AstroPlant/astroplant-hardware/Electronics/README.md

# AstroPlant Electronic

At this time there is 3 main PCB in the project:

* Extension board
* LEDs panel
* EC-pH board

The *Extension board* and the *LEDs panel* are made internaly by the AstroPlant team using kicad 5
The libraries can be found here : https://framagit.org/VincentFrangi/KiCad_AstroPlant_Lib.git

The *EC-ph board* is made by [Sparky's Widgets](https://www.sparkyswidgets.com/)

## Documentation
