AstroPlant/astroplant-hardware/Electronics/PCB/AstroPlant_ExtensionBoard/astroplant-extension-board-mk0-7/Outputs/GERBER v07/Readme.txt

To have a gerber working on eurocircuit you need zip it with the drill files
