AstroPlant/astroplant-hardware/Electronics/PCB/AstroPlant_ExtensionBoard/astroplant-extension-board-mk0-6-1/3D_model/ExtensionBoardMk06.stl

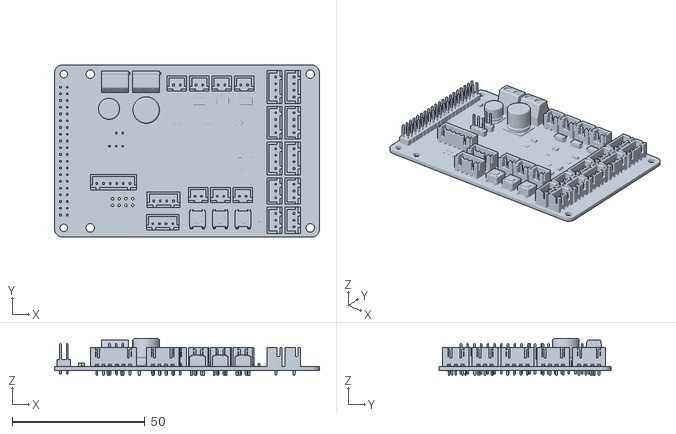
[picture p1: CAD file, 2023-10-30]
Electronics/PCB/AstroPlant_ExtensionBoard/astroplant-extension-board-mk0-6-1/3D_model/ExtensionBoardMk06.stl
100.0 x 65.0 x 14.0
