AstroPlant/astroplant-hardware/Electronics/PCB/AstroPlant_ExtensionBoard/astroplant-extension-board-mk0-7/Astroplant_AL.kicad_pcb

## KiCad design Electronics/PCB/AstroPlant_ExtensionBoard/astroplant-extension-board-mk0-7/Astroplant_AL.kicad_pcb (2023-11-22)

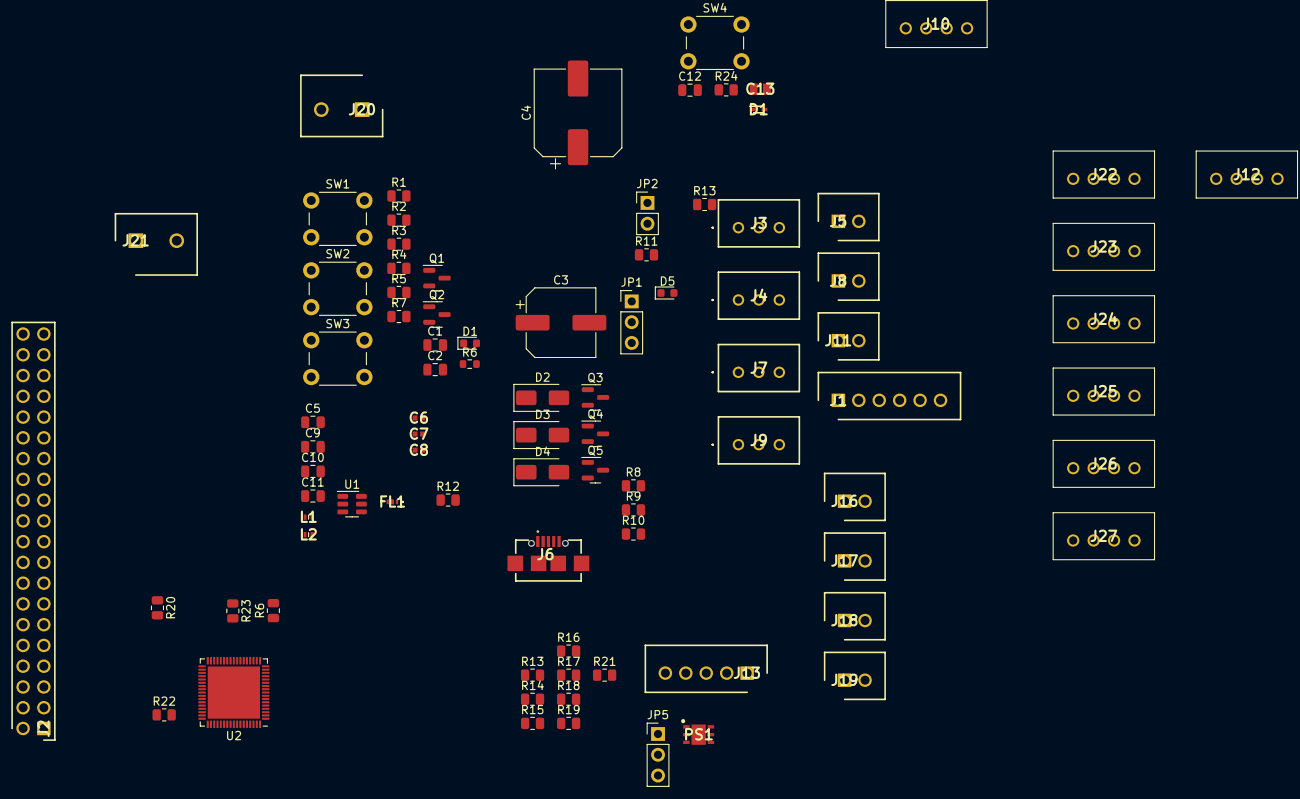
[picture p2: board Astroplant_AL.kicad_pcb from above]

Board: 2 copper layers, 88 parts (0 on the bottom side), 61 nets, no tracks yet.

Parts:
C1, C2, C5, C9, C10, C11, C12: 0.1uF; C_0805_2012Metric
C3: 470uF; CP_Elec_8x6.9
C4: 470uF; CP_Elec_10x10.5
C6: GRM1555C1H1R2WA01D; CAPC1005X55N
C7: GRM1555C1HR30WA01D; CAPC1005X55N
C8: GRM1555C1HR80BA01D; CAPC1005X55N
C13: 885012207027; CAPC2012X90N
D1: LED_Blue; LED_0603_1608Metric
D1#2: BAT54KFILM; SODFL1608X70N
D2, D3, D4: S1A; D_SMA
D5: LED_Amber; LED_0603_1608Metric
FL1: LFB182G45CGFD436
J1: JST_XH_Relays; SHDR6W64P0X250_1X6_1740X575X700P
J2: 2x40 2.5mm Header; HDRV40W64P254X254_2X20_5080X508X869P
J3, J4, J7, J9: JST-XH_3; B3BXHALFSN
J5, J8, J11, J16, J17, J18, J19: JST_HX_2; SHDR2W64P0X250_1X2_740X575X700P
J6: 629105136821; MICRO-USB_2.0-SMT-TYPE-B_
J10: JST_XH_UART; B4BXHALFSN
J12: JST-XH_LED_GND; B4BXHALFSN
J13: B5B-XH-A_LF__SN_; SHDR5W64P0X250_1X5_1490X575X700P
J20, J21: Conn_01x02; SHDR2W100P0X500_1X2_1000X750X990P
J22, J23, J24, J25, J26, J27: JST_XH_I2C; B4BXHALFSN
JP1, JP5: Jumper_3_Bridged12; PinHeader_1x03_P2.54mm_Vertical
JP2: Jumper_2_Bridged; PinHeader_1x02_P2.54mm_Vertical
L1: LQG15HS3N6S02D; LQG15WH0N7B02D
L2: LQG15HS2N7S02J; LQG15WH0N7B02D
PS1: LD39050PU33R; SON95P300X300X100-7N-D
Q1, Q2, Q3, Q4, Q5: IRLML6344TRPBF; SOT-23
R1, R2, R3, R4, R5, R6, R7, R12, R13, R13#2, R14, R15, R16, R17, R18, R19, R20, R21, R22, R23, R24: 10K; R_0805_2012Metric
R6#2: 27; R_0603_1608Metric
R8, R9, R10: 100K; R_0805_2012Metric
R11: 180; R_0805_2012Metric
SW1, SW2, SW3, SW4: SW_Push; SW_PUSH_6mm
U1: USBLC6-2SC6; SOT-23-6
U2: STM32WB55RGVx; QFN-68-1EP_8x8mm_P0.4mm_EP6.4x6.4mm

Connections:
3.3V_Generated: JP5.1 (A), PS1.4 (VOUT)
3.3V_RPi: J2.1 (3V3), J2.17 (3V3), JP5.3 (B)
5V_IN: C3.1, J20.1, JP1.1 (A), JP2.1 (A)
5V_RPi: C1.2, J2.2 (5V), J2.4 (5V), JP1.3 (B), JP2.2 (B)
+3V3: C2.2, C5.2, C9.2, C10.2, C11.2, C13.1, J1.1 (DC+), J3.2 (PW), J4.2 (PW), J6.1, J7.2 (PW), J9.2 (PW), J22.3 (PW), J24.3 (PW), J25.3 (PW), J27.3 (PW), JP5.2 (C), Q1.1 (G), Q2.1 (G), R1.1, R3.1, R5.1, R7.1, U1.5 (VBUS), U2.1 (VBAT), U2.14 (VDDA), U2.30 (VDD), U2.33 (VDDRF), U2.45 (VDD), U2.55 (VDDUSB), U2.68 (VDD)
+5V: J10.3 (PW), J23.3 (PW), J26.3 (PW), JP1.2 (C), PS1.1 (EN), PS1.6 (VIN), R2.1, R4.1, R11.1
+24V: C4.1, D2.1 (K), D3.1 (K), D4.1 (K), J16.1 (A), J17.1 (A), J18.1 (A), J19.1 (A), J21.1
GND: C1.1, C2.1, C3.2, C4.2, C5.1, C6.2, C7.2, C8.2, C9.1, C10.1, C11.1, C12.1, C13.2, D1.1 (K), D5.1 (K), FL1.2 (GND), J1.2 (DC-), J2.6 (GND), J2.9 (GND), J2.14 (GND), J2.20 (GND), J2.25 (GND), J2.30 (GND), J2.34 (GND), J2.39 (GND), J3.3 (GND), J4.3 (GND), J5.2 (B), J6.5, J7.3 (GND), J8.2 (B), J9.3 (GND), J10.4 (GND), J11.2 (B), J12.4 (GND), J13.5, J20.2, J21.2, J22.4 (GND), J23.4 (GND), J24.4 (GND), J25.4 (GND), J26.4 (GND), J27.4 (GND), PS1.2 (GND), PS1.7 (PAD), Q3.2 (S), Q4.2 (S), Q5.2 (S), R8.2, R9.2, R10.2, R12.2, R24.1, SW1.2, SW2.2, SW3.2, SW4.1, U1.2 (GND), U2.32 (VSSRF), U2.42 (VSSSMPS), U2.69 (VSS)
GPIO4: J2.7 (GCLK0/GPIO4), J7.1 (DATA), J9.1 (DATA), R7.2, R23.1
GPIO5: J2.29 (GCLK1/GPIO5), J5.1 (A), SW1.1, U2.38 (PB0)
GPIO6: J2.31 (GCLK2/GPIO6), J8.1 (A), SW2.1, U2.39 (PB1)
GPIO7: J2.26 (~CE1/GPIO7), J11.1 (A), SW3.1, U2.27 (PB2)
GPIO12: J2.32 (PWM0/GPIO12), Q3.1 (G), R8.1, U2.6 (PB8)
GPIO13: J2.33 (PWM1/GPIO13), J13.1, R6#2.1, R13.2
GPIO16: J2.36 (GPIO16), Q5.1 (G), R10.1, U2.28 (PB10)
GPIO17: J2.11 (GPIO17), J3.1 (DATA), J4.1 (DATA), R5.2, R22.1
GPIO18: J2.12 (GPIO18/PWM0), J12.2 (FAR), J13.3, R6.2
GPIO19: J2.35 (GPIO19/MISO1), Q4.1 (G), R9.1, U2.23 (PA8)
GPIO20: J2.38 (GPIO20/MOSI1), J12.1 (RED), J13.2, R15.2
GPIO21: J2.40 (GPIO21/SCLK1), J12.3 (BLUE), J13.4, R14.2
GPIO22: J2.15 (GPIO22), R21.1
GPIO23: J2.16 (GPIO23), R20.1
GPIO24: J1.4 (CH2), J2.18 (GPIO24), R16.1
GPIO25: J1.5 (CH3), J2.22 (GPIO25), R17.1
GPIO26: J1.6 (CH4), J2.37 (GPIO26), R18.1
GPIO27: J1.3 (CH1), J2.13 (GPIO27), R19.1
unnamed: C6.1, L1.2
unnamed: D1.2 (A), R6#2.2
unnamed: D1#2.1, SW4.2
unnamed: D2.2 (A), J16.2 (B), Q3.3 (D)
unnamed: D3.2 (A), J17.2 (B), Q4.3 (D)
unnamed: D4.2 (A), J18.2 (B), J19.2 (B), Q5.3 (D)
unnamed: D5.2 (A), R11.2
unnamed: FL1.1 (IN), L1.1
unnamed: C7.1, FL1.3 (OUT), L2.2
unnamed: J6.2, U1.4 (I/O2)
unnamed: J6.3, U1.6 (I/O1)
unnamed: J6.4, R12.1
unnamed: C12.2, D1#2.2, U2.8 (NRST)
unnamed: R13.1, U2.15 (PA0)
unnamed: R14.1, U2.16 (PA1)
unnamed: R15.1, U2.17 (PA2)
unnamed: R6.1, U2.18 (PA3)
unnamed: U1.3 (I/O2), U2.52 (PA11)
unnamed: U1.1 (I/O1), U2.53 (PA12)
unnamed: R23.2, U2.26 (PC5)
unnamed: R22.2, U2.50 (PC6)
unnamed: R21.2, U2.58 (PC10)
unnamed: R20.2, U2.59 (PC11)
unnamed: R16.2, U2.60 (PC12)
unnamed: R17.2, U2.2 (PC13)
unnamed: R18.2, U2.3 (PC14)
unnamed: R19.2, U2.4 (PC15)
unnamed: R24.2, U2.5 (PH3)
unnamed: C8.1, L2.1, U2.31 (RF1)
RX: J2.10 (GPIO15/RXD), J10.2 (RX), U2.51 (PA10)
SCL: J2.5 (SCL/GPIO3), J22.2 (SCL), J24.2 (SCL), J25.2 (SCL), J27.2 (SCL), Q2.2 (S), R3.2, U2.65 (PB5)
SCL_5V: J23.2 (SCL), J26.2 (SCL), Q2.3 (D), R4.2
SDA: J2.3 (SDA/GPIO2), J22.1 (SDA), J24.1 (SDA), J25.1 (SDA), J27.1 (SDA), Q1.2 (S), R1.2, U2.66 (PB6)
SDA_5V: J23.1 (SDA), J26.1 (SDA), Q1.3 (D), R2.2
TX: J2.8 (GPIO14/TXD), J10.1 (TX), U2.24 (PA9)
