AstroPlant/astroplant-hardware/Electronics/PCB/AstroPlant_ExtensionBoard/astroplant-extension-board-mk0-6-1/Astroplant_VFR.kicad_pcb

## KiCad design Electronics/PCB/AstroPlant_ExtensionBoard/astroplant-extension-board-mk0-6-1/Astroplant_VFR.kicad_pcb (2023-10-30)

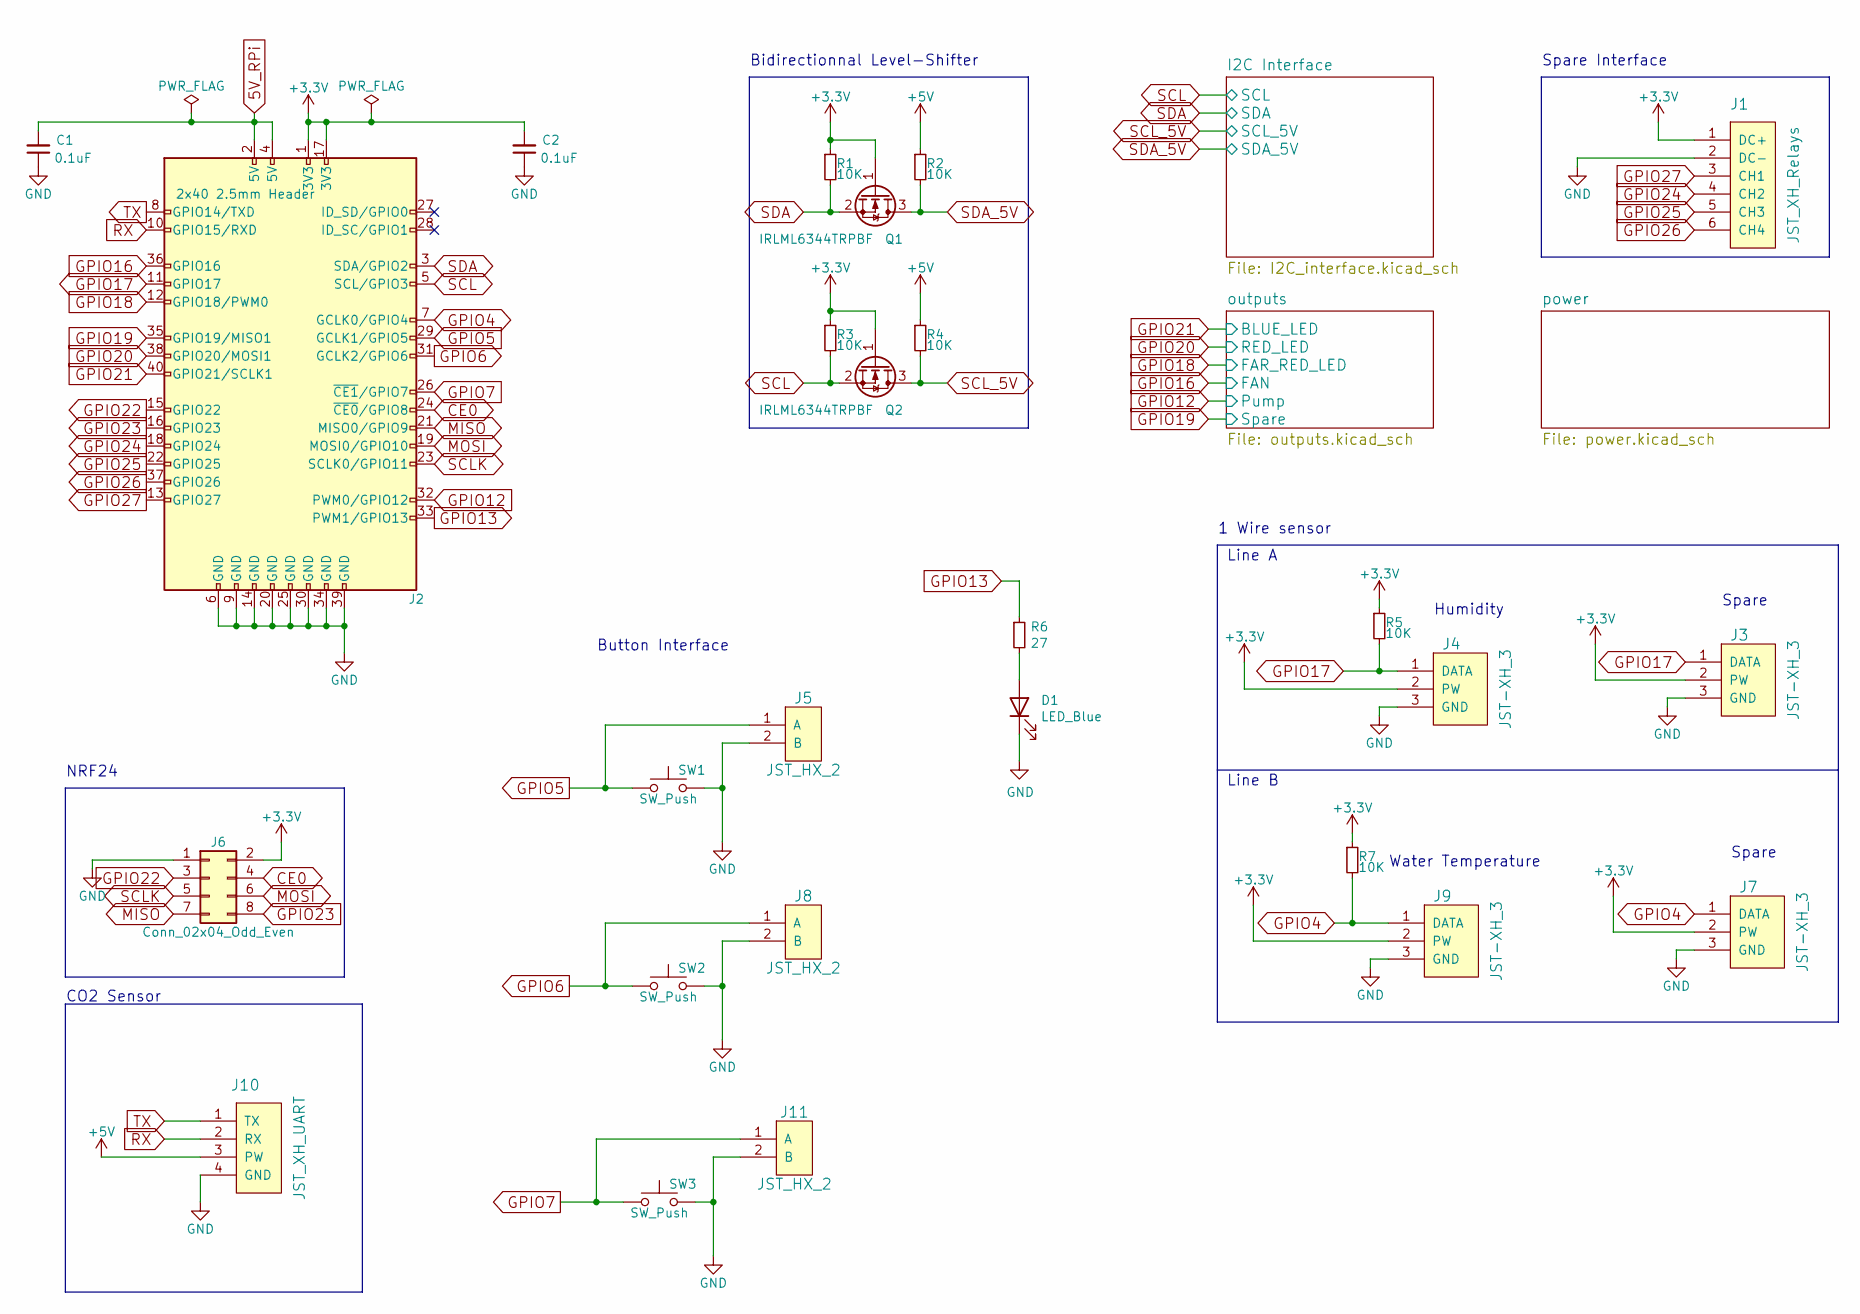
[picture p3: schematic Astroplant_VFR.kicad_sch, Astroplant Root]

Parts:
C1, C2: 0.1uF; C_0805_2012Metric; MPN 08055C104JAT2A; Digikey Part Number 478-3352-1-ND
D1: LED_Blue; LED_0603_1608Metric; MPN SMLEN3BC8TT86; Mouser PN 755-SMLEN3BC8TT86
J1: JST_XH_Relays; JST_XH_B06B-XH-A_1x06_P2.50mm_Vertical; MPN B6B-XH-A(LF)(SN); Digikey Part Number 455-2271-ND
J2: 2x40 2.5mm Header; Pin_Header_Straight_2x20_Pitch2.54mm; MPN 61304021121; Digikey Part Number 732-5310-ND
J3, J4, J7, J9: JST-XH_3; JST_XH_B03B-XH-A_1x03_P2.50mm_Vertical; MPN B3B-XH-A(LF)(SN); Digikey Part Number 455-2248-ND
J5, J8, J11: JST_HX_2; JST_XH_B02B-XH-A_1x02_P2.50mm_Vertical; MPN B2B-XH-A(LF)(SN); Digikey Part Number 455-2247-ND
J6: Conn_02x04_Odd_Even; Pin_Header_Straight_2x04_Pitch2.54mm
J10: JST_XH_UART; JST_XH_B04B-XH-A_1x04_P2.50mm_Vertical; MPN B4B-XH-A(LF)(SN); Digikey Part Number 455-2249-ND
Q1, Q2: IRLML6344TRPBF; SOT-23; MPN IRLML6344TRPBF; Digikey Part Number IRLML6344TRPBFCT-ND
R1, R2, R3, R4: 10K; R_0805_2012Metric; MPN RC0805FR-0710KL; Digikey PN 311-10.0KCRCT-ND
R5, R7: 10K; R_0805_2012Metric; MPN RC0805FR-0710KL; Digikey Part Number 311-10.0KCRCT-ND
R6: 27; R_0603_1608Metric; MPN RR0816Q-270-D; Digikey PN RR08Q27DCT-ND
SW1, SW2, SW3: SW_Push; SW_PUSH_6mm; MPN 430156043726; Mouser Part Number 710-430156043726

Connections:
5V_RPi: C1.2, J2.2 (5V), J2.4 (5V); also elsewhere on the board
+3V3: C2.2, J1.1 (DC+), J2.1 (3V3), J2.17 (3V3), J3.2 (PW), J4.2 (PW), J6.2, J7.2 (PW), J9.2 (PW), Q1.1 (G), Q2.1 (G), R1.1, R3.1, R5.1, R7.1; also elsewhere on the board
+5V: J10.3 (PW), R2.1, R4.1; also elsewhere on the board
CE0: J2.24 (~CE0/GPIO8), J6.4
GND: C1.1, C2.1, D1.1 (K), J1.2 (DC-), J2.6 (GND), J2.9 (GND), J2.14 (GND), J2.20 (GND), J2.25 (GND), J2.30 (GND), J2.34 (GND), J2.39 (GND), J3.3 (GND), J4.3 (GND), J5.2 (B), J6.1, J7.3 (GND), J8.2 (B), J9.3 (GND), J10.4 (GND), J11.2 (B), SW1.2, SW2.2, SW3.2; also elsewhere on the board
GPIO4: J2.7 (GCLK0/GPIO4), J7.1 (DATA), J9.1 (DATA), R7.2
GPIO5: J2.29 (GCLK1/GPIO5), J5.1 (A), SW1.1
GPIO6: J2.31 (GCLK2/GPIO6), J8.1 (A), SW2.1
GPIO7: J2.26 (~CE1/GPIO7), J11.1 (A), SW3.1
GPIO12: J2.32 (PWM0/GPIO12); also elsewhere on the board
GPIO13: J2.33 (PWM1/GPIO13), R6.1
GPIO16: J2.36 (GPIO16); also elsewhere on the board
GPIO17: J2.11 (GPIO17), J3.1 (DATA), J4.1 (DATA), R5.2
GPIO18: J2.12 (GPIO18/PWM0); also elsewhere on the board
GPIO19: J2.35 (GPIO19/MISO1); also elsewhere on the board
GPIO20: J2.38 (GPIO20/MOSI1); also elsewhere on the board
GPIO21: J2.40 (GPIO21/SCLK1); also elsewhere on the board
GPIO22: J2.15 (GPIO22), J6.3
GPIO23: J2.16 (GPIO23), J6.8
GPIO24: J1.4 (CH2), J2.18 (GPIO24)
GPIO25: J1.5 (CH3), J2.22 (GPIO25)
GPIO26: J1.6 (CH4), J2.37 (GPIO26)
GPIO27: J1.3 (CH1), J2.13 (GPIO27)
MISO: J2.21 (MISO0/GPIO9), J6.7
MOSI: J2.19 (MOSI0/GPIO10), J6.6
unnamed: D1.2 (A), R6.2
RX: J2.10 (GPIO15/RXD), J10.2 (RX)
SCL: J2.5 (SCL/GPIO3), Q2.2 (S), R3.2; also elsewhere on the board
SCLK: J2.23 (SCLK0/GPIO11), J6.5
SCL_5V: Q2.3 (D), R4.2; also elsewhere on the board
SDA: J2.3 (SDA/GPIO2), Q1.2 (S), R1.2; also elsewhere on the board
SDA_5V: Q1.3 (D), R2.2; also elsewhere on the board
TX: J2.8 (GPIO14/TXD), J10.1 (TX)

Notes on the sheet:
NRF24
Button Interface
Bidirectionnal Level-Shifter
Humidity
1 Wire sensor
Spare Interface
Line B
CO2 Sensor
Water Temperature
Spare
Line A

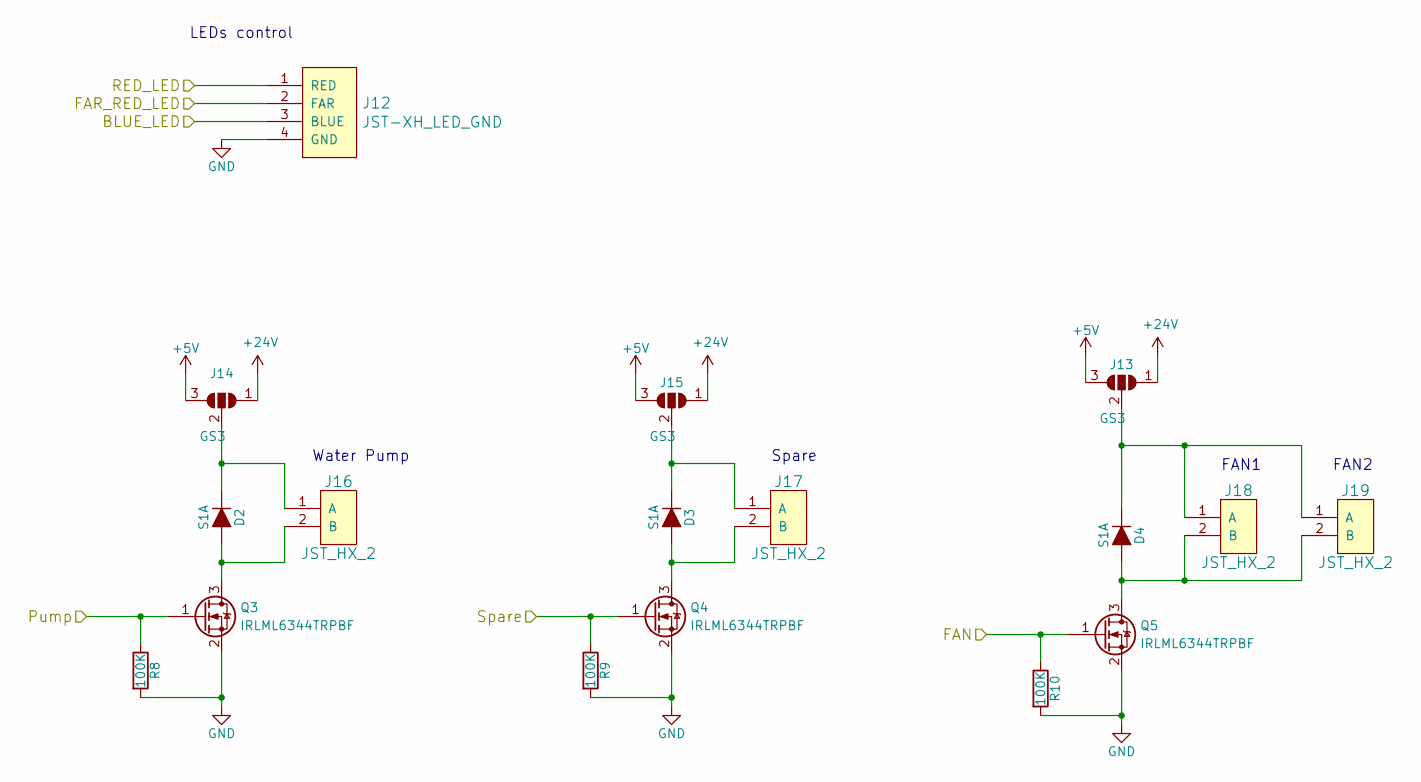
[picture p4: schematic outputs.kicad_sch, Astroplant Power Interface]

Parts:
D2, D3, D4: S1A; D_SMA; MPN S1A-13-F; Digikey Part Number S1AFSCT-ND
J12: JST-XH_LED_GND; JST_XH_B04B-XH-A_1x04_P2.50mm_Vertical
J13, J14, J15: GS3; SolderJumper-3_P2.0mm_Open_TrianglePad1.0x1.5mm
J16, J17, J18, J19: JST_HX_2; JST_XH_B02B-XH-A_1x02_P2.50mm_Vertical; MPN B2B-XH-A(LF)(SN); Digikey Part Number 455-2247-ND
Q3, Q4, Q5: IRLML6344TRPBF; SOT-23; MPN IRLML6344TRPBF; Digikey Part Number IRLML6344TRPBFCT-ND
R8, R9, R10: 100K; R_0805_2012Metric; MPN RC0805FR-07100KL; Digikey Part Number 311-100KCRCT-ND

Connections:
+5V: J13.3 (B), J14.3 (B), J15.3 (B); also elsewhere on the board
+24V: J13.1 (A), J14.1 (A), J15.1 (A); also elsewhere on the board
GND: J12.4 (GND), Q3.2 (S), Q4.2 (S), Q5.2 (S), R8.2, R9.2, R10.2; also elsewhere on the board
GPIO12: Q3.1 (G), R8.1; also elsewhere on the board
GPIO16: Q5.1 (G), R10.1; also elsewhere on the board
GPIO18: J12.2 (FAR); also elsewhere on the board
GPIO19: Q4.1 (G), R9.1; also elsewhere on the board
GPIO20: J12.1 (RED); also elsewhere on the board
GPIO21: J12.3 (BLUE); also elsewhere on the board
unnamed: D2.2 (A), J16.2 (B), Q3.3 (D)
unnamed: D2.1 (K), J14.2 (C), J16.1 (A)
unnamed: D3.2 (A), J17.2 (B), Q4.3 (D)
unnamed: D3.1 (K), J15.2 (C), J17.1 (A)
unnamed: D4.2 (A), J18.2 (B), J19.2 (B), Q5.3 (D)
unnamed: D4.1 (K), J13.2 (C), J18.1 (A), J19.1 (A)

Notes on the sheet:
Spare
LEDs control
Water Pump
FAN2
FAN1

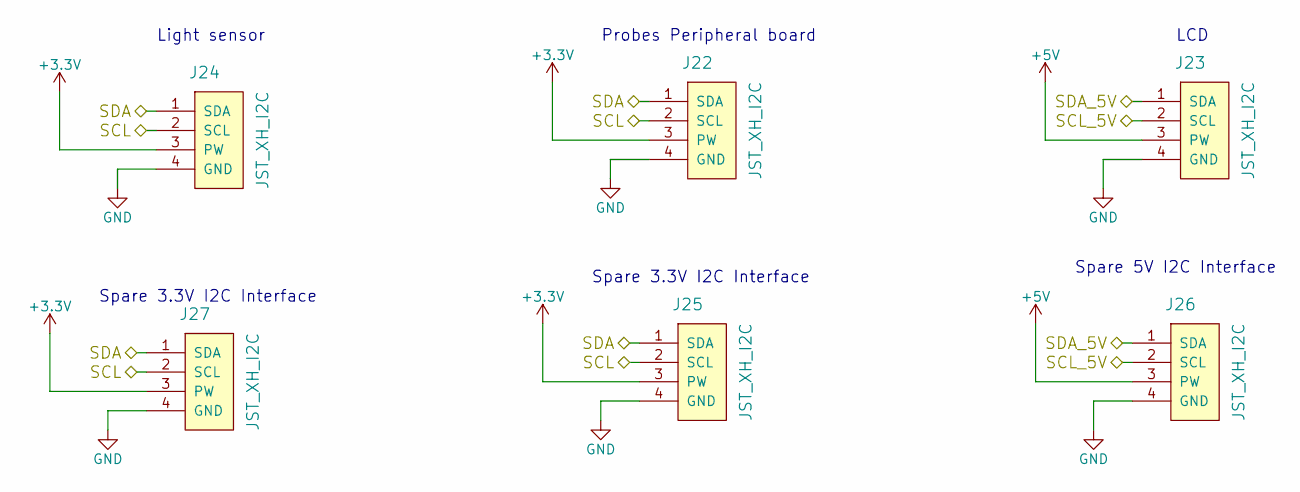
[picture p5: schematic I2C_interface.kicad_sch, I2C Interface]

Parts:
J22, J23, J24, J25, J26, J27: JST_XH_I2C; JST_XH_B04B-XH-A_1x04_P2.50mm_Vertical; MPN B4B-XH-A(LF)(SN); Digikey Part Number 455-2249-ND

Connections:
+3V3: J22.3 (PW), J24.3 (PW), J25.3 (PW), J27.3 (PW); also elsewhere on the board
+5V: J23.3 (PW), J26.3 (PW); also elsewhere on the board
GND: J22.4 (GND), J23.4 (GND), J24.4 (GND), J25.4 (GND), J26.4 (GND), J27.4 (GND); also elsewhere on the board
SCL: J22.2 (SCL), J24.2 (SCL), J25.2 (SCL), J27.2 (SCL); also elsewhere on the board
SCL_5V: J23.2 (SCL), J26.2 (SCL); also elsewhere on the board
SDA: J22.1 (SDA), J24.1 (SDA), J25.1 (SDA), J27.1 (SDA); also elsewhere on the board
SDA_5V: J23.1 (SDA), J26.1 (SDA); also elsewhere on the board

Notes on the sheet:
Spare 5V I2C Interface
Light sensor
LCD
Spare 3.3V I2C Interface
Probes Peripheral board

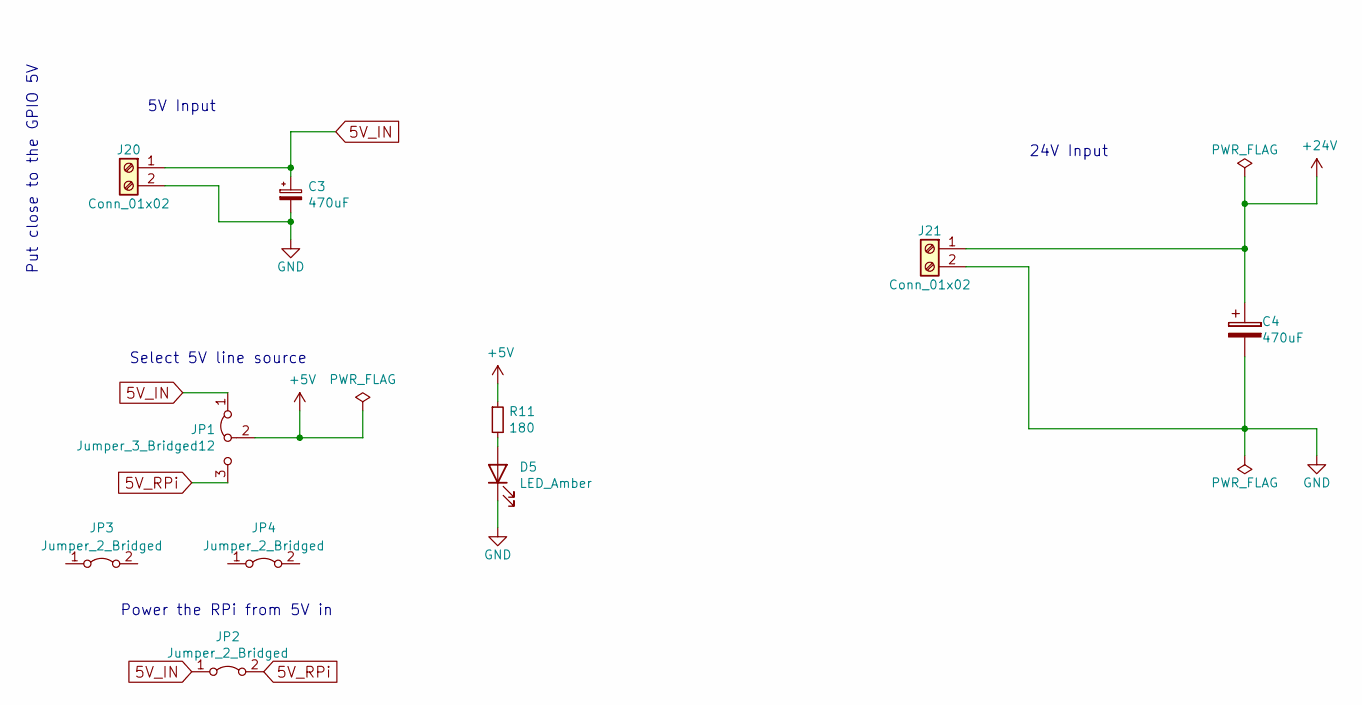
[picture p6: schematic power.kicad_sch, Power management]

Parts:
C3: 470uF; CP_Elec_8x6.9; MPN 875115150005; Digikey PN 732-6443-1-ND
C4: 470uF; CP_Elec_10x10.5; MPN EEH-ZK1E471P; Digikey PN P121398CT-ND
D5: LED_Amber; LED_0603_1608Metric; MPN SML-D12D8WT8; Mouser PN 755-SML-D12D8WT86C
J20: Conn_01x02; TerminalBlock_bornier-2_P5.08mm; MPN 691102710002; Digikey Part Number 710-691102710002
J21: Conn_01x02; TerminalBlock_bornier-2_P5.08mm; MPN 691102710002; Mouser Part Number 710-691102710002
JP1: Jumper_3_Bridged12; PinHeader_1x03_P2.54mm_Vertical; MPN 61300311121; Digikey PN 732-5316-ND
JP2: Jumper_2_Bridged; PinHeader_1x02_P2.54mm_Vertical; MPN 61300211121; Digikey PN 732-5315-ND
JP3, JP4: Jumper_2_Bridged; MPN 60900213421
R11: 180; R_0805_2012Metric; MPN ESR10EZPJ181; Digikey PN RHM180KCT-ND

Connections:
5V_IN: C3.1, J20.1, JP1.1 (A), JP2.1 (A)
5V_RPi: JP1.3 (B), JP2.2 (B); also elsewhere on the board
+5V: JP1.2 (C), R11.1; also elsewhere on the board
+24V: C4.1, J21.1; also elsewhere on the board
GND: C3.2, C4.2, D5.1 (K), J20.2, J21.2; also elsewhere on the board
unnamed: D5.2 (A), R11.2

Notes on the sheet:
24V Input
Select 5V line source
5V Input
Power the RPi from 5V in
Put close to the GPIO 5V

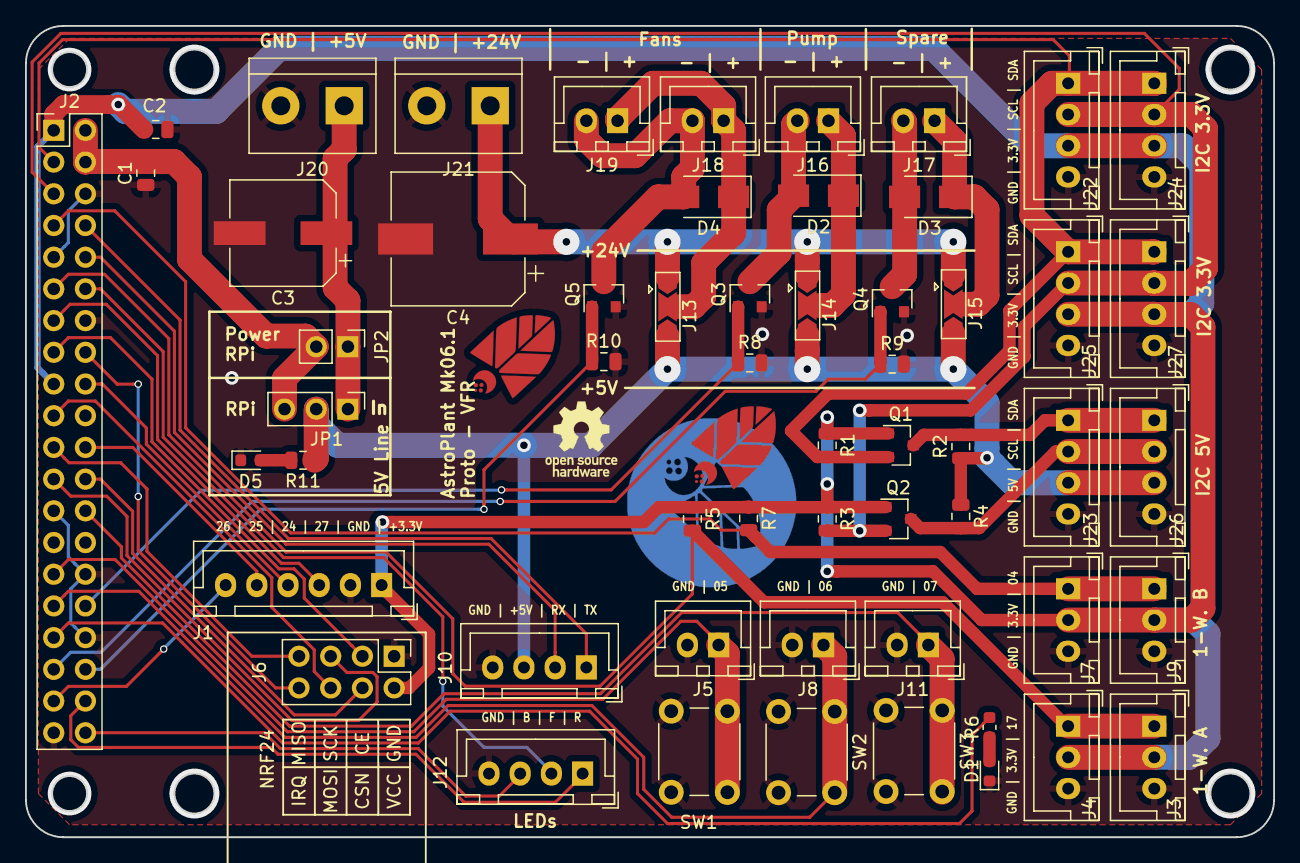
[picture p7: board Astroplant_VFR.kicad_pcb from above]

Board: 2 copper layers, 100.0 x 65.0 mm, 57 parts (0 on the bottom side), 42 nets.
