AstroPlant/astroplant-hardware/(commit log)

2018-09-21 add extension board mk06 as submodule
2018-09-21 add extension board mk05 as submodule
2018-09-21 add extension LEDs mk0.1-2 as submodule
2018-10-08 Add production files for leds and mk0 extension board
2018-10-12 add power wiring svg schematics
2018-11-19 Extension Mk06 add gerber bottom mask
2018-11-27 add position to extension Mk06 and leds
2018-12-09 update wiring schematics
2023-10-18 Add new mk0.6.1 version (component replacement)
    [Astroplant_VFR-B.SilkS.dxf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]
2023-10-20 Remove obselete files
    [Astroplant_VFR-B.Cu.gbr, Astroplant_VFR-B.Mask.gbr, Astroplant_VFR-B.SilkS.gbr, Astroplant_VFR-Eco2.User.gbr, Astroplant_VFR-Edge.Cuts.gbr, Astroplant_VFR-F.Cu.gbr, Astroplant_VFR-F.Mask.gbr, Astroplant_VFR-F.SilkS.gbr]
2023-10-20 improved readme + deletion of other unnecessary files
    [Astroplant_VFR.sch, I2C_interface.sch, outputs.sch, power.sch]
2023-11-02 First commit of MK07
    [Astroplant_AL.kicad_pcb, Astroplant_AL.kicad_sch, Astroplant_VFR-B.SilkS.dxf, Astroplant_VFR-F.SilkS.dxf, I2C_Interface.kicad_sch, Microcontroller.kicad_sch, USB_interface.kicad_sch, outputs.kicad_sch]
2023-11-17 Update schematic and change library path
    [Astroplant_AL.kicad_pcb, Astroplant_AL.kicad_sch, Astroplant_VFR-B.SilkS.dxf, Astroplant_VFR-F.SilkS.dxf, I2C_Interface.kicad_sch, I2C_interface.kicad_sch, Microcontroller.kicad_sch, outputs.kicad_sch]
2023-11-22 Convert all absolute paths to relative ones with forward slashes
    [Astroplant_AL.kicad_pcb]
2023-11-22 Place components on PCB
    [Astroplant_AL.kicad_pcb, Astroplant_AL.kicad_sch, Microcontroller.kicad_sch, outputs.kicad_sch, power.kicad_sch]
2023-11-22 Fix remaining absolute paths
    [Astroplant_AL.kicad_pcb]
2023-11-24 Add route to PCB
    Not the final version of the PCB, missing components for the antenna and also non-component things like the astroplant logo, the version and placement of the component designators.
    [Astroplant_AL.kicad_pcb, Astroplant_AL.kicad_sch, Microcontroller.kicad_sch]
2023-11-26 Fix accidentally committed conflicts
    [Astroplant_AL.kicad_pcb]
2023-11-29 Completed version of the project
    Generate outputs (BOM, Drill, Pkp, Gerber)
    Added connectors descritption (like "I2C 3.3V" dor the corresponding connector)
    Added a connector to an external antenna
    Changed routing
    Changed component placement
    Added a script to generate a usable BOM
    [Astroplant_AL-B_Cu.gbr, Astroplant_AL-B_Mask.gbr, Astroplant_AL-B_Paste.gbr, Astroplant_AL-B_Silkscreen.gbr, Astroplant_AL-Edge_Cuts.gbr, Astroplant_AL-F_Cu.gbr, Astroplant_AL-F_Mask.gbr, Astroplant_AL-F_Paste.gbr]
2023-11-29 Changed USB connector's pad, and updatded gerbers
    [Astroplant_AL-B_Cu.gbr, Astroplant_AL-B_Mask.gbr, Astroplant_AL-B_Paste.gbr, Astroplant_AL-B_Silkscreen.gbr, Astroplant_AL-Edge_Cuts.gbr, Astroplant_AL-F_Cu.gbr, Astroplant_AL-F_Mask.gbr, Astroplant_AL-F_Paste.gbr]
2023-11-29 Added text to give information about the jumper connector and updated gerber
    [Astroplant_AL-B_Cu.gbr, Astroplant_AL-B_Mask.gbr, Astroplant_AL-B_Paste.gbr, Astroplant_AL-B_Silkscreen.gbr, Astroplant_AL-Edge_Cuts.gbr, Astroplant_AL-F_Cu.gbr, Astroplant_AL-F_Mask.gbr, Astroplant_AL-F_Paste.gbr]
2023-11-29 Solved processing notes from aisler by changing micro usb connector
    [Astroplant_AL-B_Cu.gbr, Astroplant_AL-B_Mask.gbr, Astroplant_AL-B_Paste.gbr, Astroplant_AL-B_Silkscreen.gbr, Astroplant_AL-Edge_Cuts.gbr, Astroplant_AL-F_Cu.gbr, Astroplant_AL-F_Mask.gbr, Astroplant_AL-F_Paste.gbr]
2023-11-30 Changed PCB, add a LED to simplify tests
    [Astroplant_AL-B_Cu.gbr, Astroplant_AL-B_Mask.gbr, Astroplant_AL-B_Paste.gbr, Astroplant_AL-B_Silkscreen.gbr, Astroplant_AL-Edge_Cuts.gbr, Astroplant_AL-F_Cu.gbr, Astroplant_AL-F_Mask.gbr, Astroplant_AL-F_Paste.gbr]
2024-03-22 Updated PCB from a backup save, solve issues of the 1st prototype
    [Astroplant_AL-B_Cu.gbr, Astroplant_AL-B_Mask.gbr, Astroplant_AL-B_Paste.gbr, Astroplant_AL-B_Silkscreen.gbr, Astroplant_AL-Edge_Cuts.gbr, Astroplant_AL-F_Cu.gbr, Astroplant_AL-F_Mask.gbr, Astroplant_AL-F_Paste.gbr]
